nelsonjchen/wet-dry-vac-to-dreame-l50-ultra-adapter/models/dewalt-to-dewalt-90-elbow.step

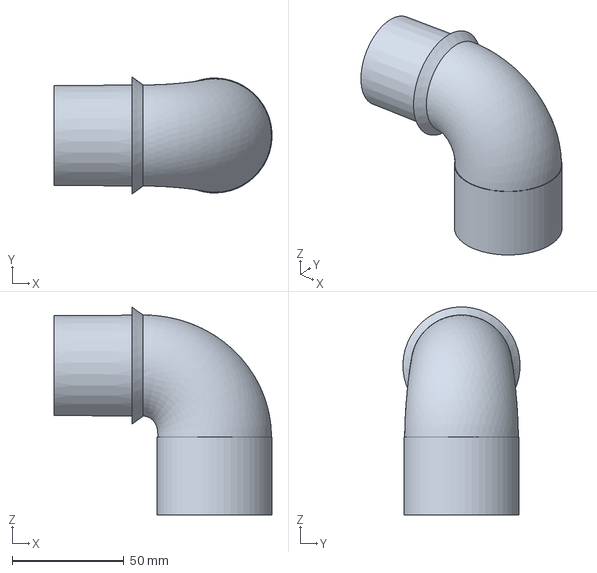
[picture p3: CAD file, 2026-11-08]
models/dewalt-to-dewalt-90-elbow.step
97.7 x 52.5 x 93.2 mm
