nelsonjchen/wet-dry-vac-to-dreame-l50-ultra-adapter/models/hose-adapter-rev5.step

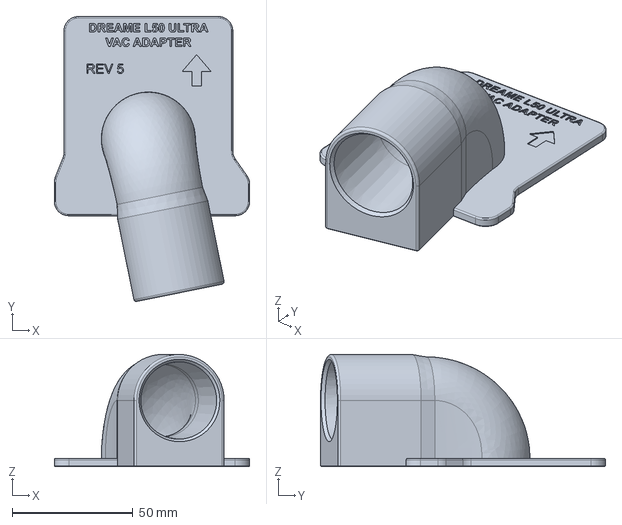
[picture p4: CAD file, 2026-11-08]
models/hose-adapter-rev5.step
81.0 x 118.1 x 46.5 mm
