nelsonjchen/wet-dry-vac-to-dreame-l50-ultra-adapter/models/stanley-to-stanley-90-elbow.step

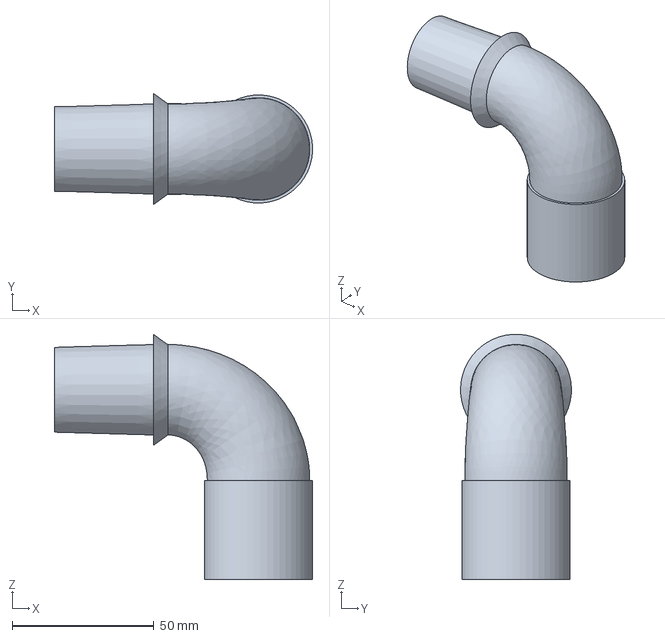
[picture p5: CAD file, 2026-11-08]
models/stanley-to-stanley-90-elbow.step
91.0 x 39.1 x 86.5 mm
