nelsonjchen/wet-dry-vac-to-dreame-l50-ultra-adapter/models/hose-adapter-rev5-dewalt-measured.step

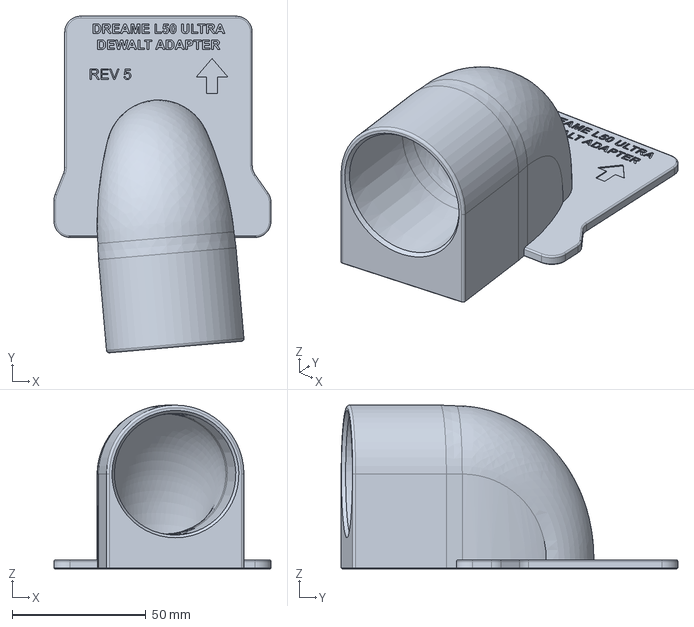
[picture p6: CAD file, 2026-11-08]
models/hose-adapter-rev5-dewalt-measured.step
81.0 x 125.7 x 61.2 mm
