nelsonjchen/wet-dry-vac-to-dreame-l50-ultra-adapter/(list of files, cad)

Other CAD files:
models/dewalt-to-dewalt-90-elbow.stl
models/hose-adapter-rev5-dewalt-measured.stl
models/hose-adapter-rev5.stl
models/stanley-to-stanley-90-elbow.stl
