nelsonjchen/wet-dry-vac-to-dreame-l50-ultra-adapter/measurements/scans/2026-09-19/README.md

# Vacuum bag interface flatbed reference

Captured on 2026-09-19 from the Brother MFC-L3780CDW flatbed (network name: Master Bedroom Printer).

- Original, unmodified scanner output: `vacuum-bag-interface-with-library-card-200dpi.jpg`.
- Image: 1696 × 2203 pixels, color JPEG; embedded resolution: 200 × 200 dpi.
- Requested resolution: 600 × 600 dpi. The device returned 200 dpi instead; do not use the requested resolution to measure this image.
- Both the vacuum bag's plastic interface and the library card are visible. The user supplied the card as an ISO standard size reference.
- Intended use: reference for correcting the rounded rectangular adapter interface, which the user reports is not a perfect fit.
- No geometry or dimensions have yet been inferred from the image. Calibrate against the card before deriving dimensions; raised surfaces and shadows can affect apparent edges.
- Scan request and response headers are preserved alongside the image.
- SHA-256 of original JPEG: `ff3c3854313bd551bb64a619af86a164ccd92518b56cf5718e04ea035be0c187`.
