nelsonjchen/wet-dry-vac-to-dreame-l50-ultra-adapter/measurements/scans/2026-09-19/vacuum-bag-interface-with-library-card-200dpi.jpg

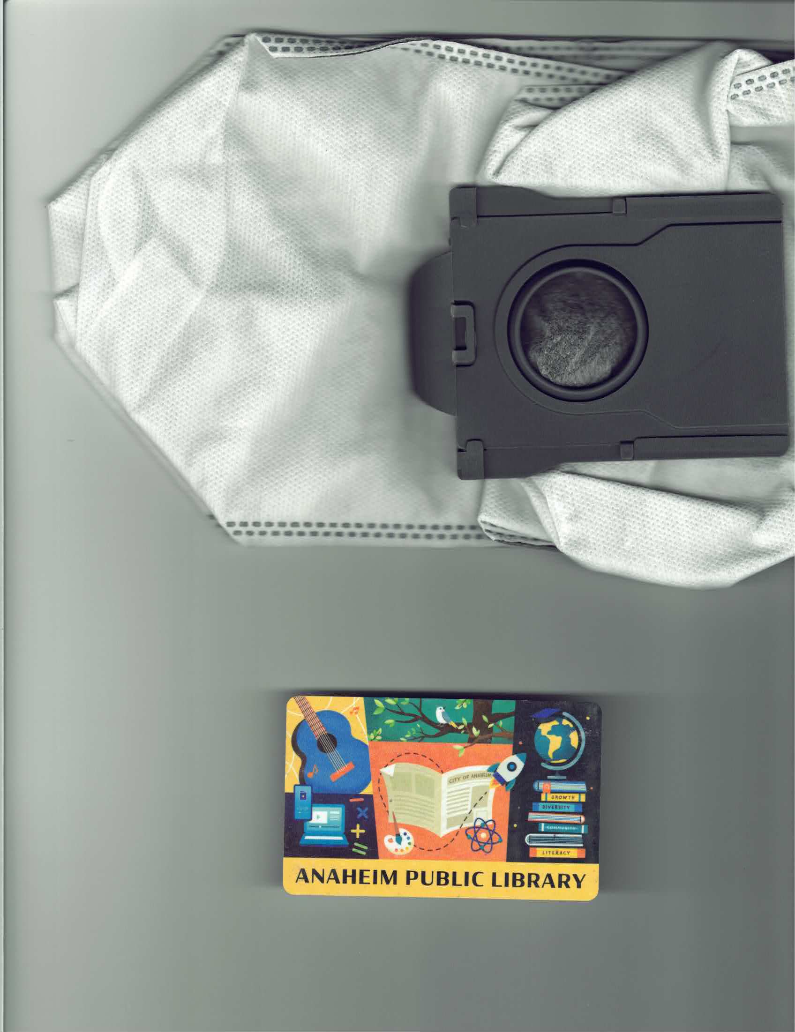
measurements/scans/2026-09-19/vacuum-bag-interface-with-library-card-200dpi.jpg
