nelsonjchen/wet-dry-vac-to-dreame-l50-ultra-adapter/(commit log)

2026-09-15 Add build123d CAD experiment
2026-09-15 Add single-card dock interface and print-supported hose elbow
2026-09-19 Add adjustable tapered hose socket and clearance-aware outlet aiming
2026-09-19 Add blind retained TPU seal and REV 1 print labels
2026-09-20 Record tested socket fit and REV 4 card with pull tab
2026-09-20 Add REV 5 tapered elbow with smooth printable support
2026-11-08 Prepare Stanley and DeWalt adapter models for public sharing
    [dewalt-to-dewalt-90-elbow.step, dewalt-to-dewalt-90-elbow.stl, hose-adapter-rev5-dewalt-measured.step, hose-adapter-rev5-dewalt-measured.stl, hose-adapter-rev5.step, hose-adapter-rev5.stl, stanley-to-stanley-90-elbow.step, stanley-to-stanley-90-elbow.stl]
2026-11-08 Document completed setup, inlet provenance, and ESPHome switch
